tylergehring/Lux2ISO/docs/phase2/SchematicPhase2.jpg

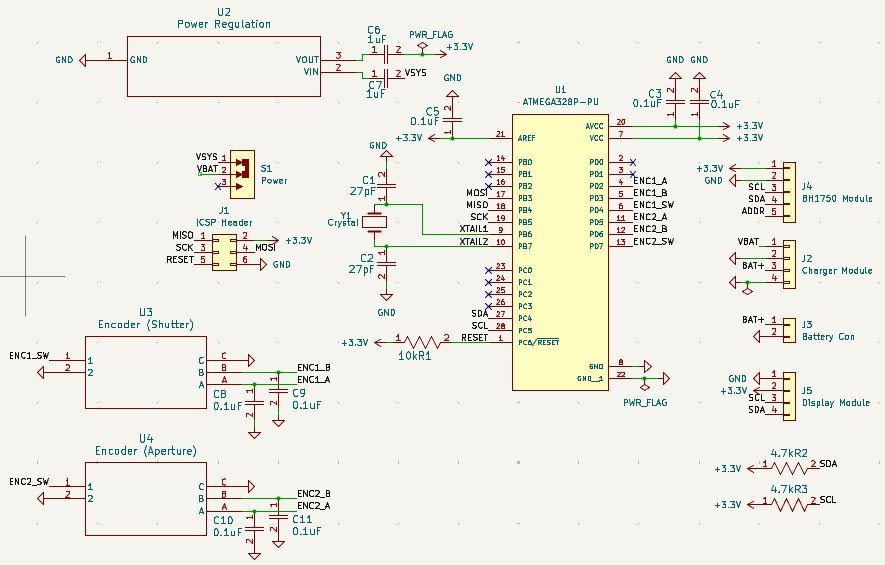
docs/phase2/SchematicPhase2.jpg
