tylergehring/Lux2ISO/docs/phase3/phase3_intended_final_schematic.png

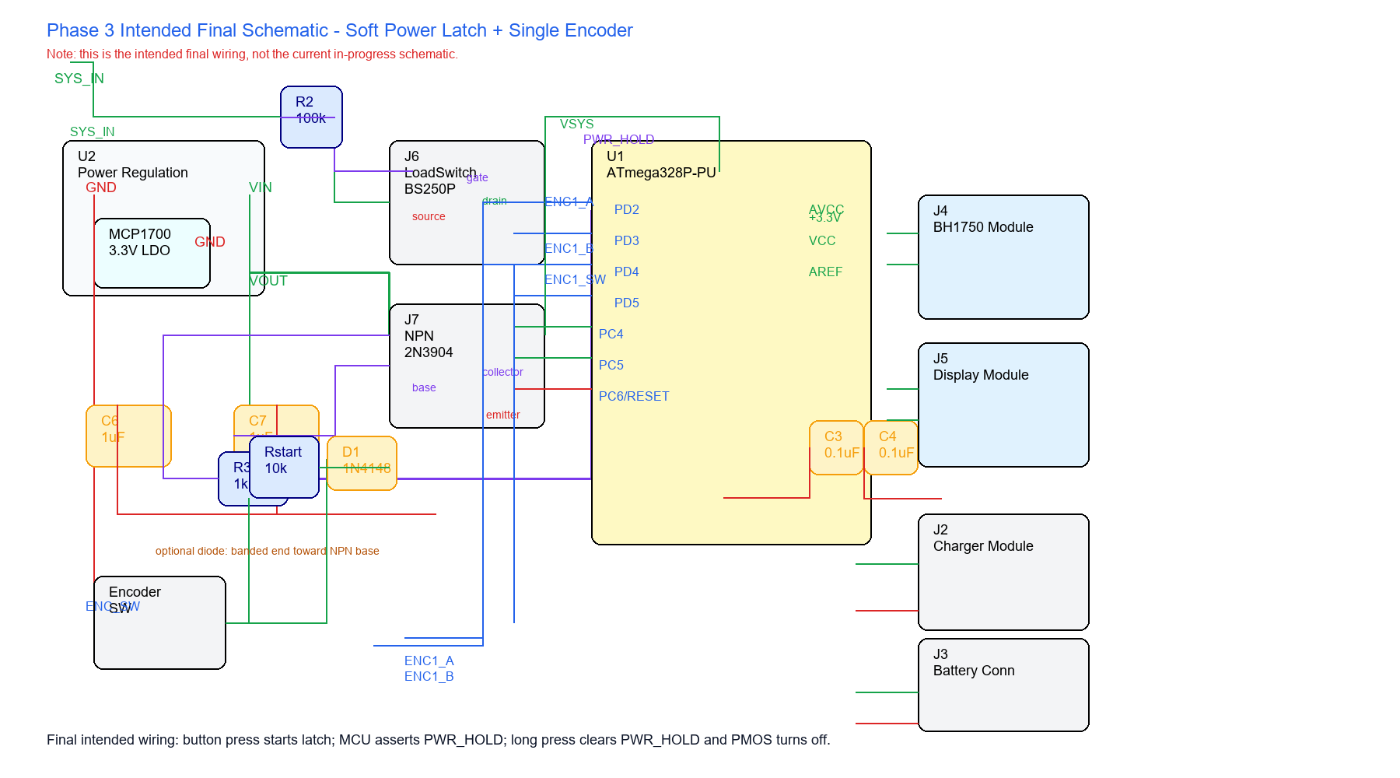
docs/phase3/phase3_intended_final_schematic.png
