tylergehring/Lux2ISO/docs/phase2/Phase2-BOM.md

# Lux2ISO Phase 2 — Complete Bill of Materials

All parts required to build Phase 2 from scratch. Links are verified against live DigiKey and Amazon listings.
Prices are unit prices at qty 1 in USD; verify current pricing before ordering.

---

## DigiKey Order

> Primary order: all ICs, passives, connectors, encoders, and PCB parts.

### Microcontroller & Clock

| Qty | Part Number | Description | Unit Price | DigiKey Link |
|-----|---|---|---|---|
| 1 | ATMEGA328P-PU | ATmega328P-PU, DIP-28, 8-bit MCU | $2.89 | [Link](https://www.digikey.com/en/products/detail/microchip-technology/ATMEGA328P-PU/1914589) |
| 1 | ED28DT | DIP-28 IC socket, 0.3" row spacing | $0.35 | [Link](https://www.digikey.com/en/products/detail/on-shore-technology-inc/ED28DT/4147600) |
| 1 | HC-49-U-S8000000ABJB | 8.000 MHz HC-49/U-S crystal | ~$0.50 | [Link](https://www.digikey.com/en/products/detail/citizen-finedevice-co-ltd/HC-49-U-S8000000ABJB/284205) |
| 2 | K270J15C0GF5TL2 | 27 pF C0G ceramic disc cap (crystal load caps) | ~$0.40 ea | [Link](https://www.digikey.com/en/products/detail/vishay-beyschlag-draloric-bc-components/K270J15C0GF5TL2/286460) |

### 3.3 V Power Regulation

| Qty | Part Number | Description | Unit Price | DigiKey Link |
|-----|---|---|---|---|
| 1 | MCP1700-3302E/TO | 3.3 V LDO, 250 mA, TO-92 **— use inline PCB footprint** | ~$0.50 | [Link](https://www.digikey.com/en/products/detail/microchip-technology/MCP1700-3302E-TO/652680) |
| 2 | *(any 1 µF radial electrolytic, 10 V+)* | 1 µF radial electrolytic (VIN + VOUT bypass, C8/C9) — search DigiKey for any in-stock Nichicon or Panasonic 1 µF 10 V or 16 V radial | ~$0.15 ea | [DigiKey search](https://www.digikey.com/en/products/filter/aluminum-electrolytic-capacitors/58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) |

> **MCP1700 soldering note:** Use the **TO-92 inline footprint** on the PCB (`Package_TO_SOT_THT:TO-92_Inline` in KiCad). Place the three holes in a straight line at **2.54 mm (0.1") pitch** instead of the standard cramped triangle. Bend the two outer leads of the TO-92 outward to match before inserting. This gives standard 0.1" clearance between adjacent pads, eliminating solder bridging. Do **not** use the standard triangle footprint.  
> **Note:** MCP1700 VIN will never exceed ~4.2 V (fully charged Li-Po). Any 1 µF radial aluminum electrolytic rated **≥10 V** works here. Search DigiKey for "1uF 10V radial electrolytic" and pick any in-stock Nichicon or Panasonic unit.

> **Note:** for the 1uF radical electrolytic I found this one "https://www.digikey.com/en/products/detail/w%C3%BCrth-elektronik/860020672005/5727088"

### USB-C Li-Po Charging

> All Li-Po charger ICs (MCP73831, TP4056, LTC4054, etc.) are SMD-only — no through-hole DIP version exists for any of them. The solution is to use a **TP4056 USB-C module** (see Amazon order below). The module mounts on the PCB via 2.54 mm through-hole pins and contains the charger IC, protection circuit, USB-C connector, and charge/fault indicator LEDs all on its own small PCB. No discrete SMD parts are required.

**TP4056 module pin connections to main PCB:**

| Module Pin | Connect to |
|---|---|
| OUT+ | Power switch input (VSYS+) |
| OUT− | GND |
| B+ | Li-Po battery positive |
| B− | Li-Po battery negative / GND |

> The module's built-in USB-C port accepts the charger cable directly — no separate USB-C connector is needed on the main PCB.

### Rotary Encoders

| Qty | Part Number | Description | Unit Price | DigiKey Link |
|-----|---|---|---|---|
| 2 | PEC11R-4215F-S0024 | Bourns 24-detent incremental encoder, integrated push switch, 15 mm shaft | $2.27 ea | [Link](https://www.digikey.com/en/products/detail/bourns-inc/PEC11R-4215F-S0024/4499665) |
| 4 | K104K15X7RF5TL2 | 100 nF X7R ceramic cap (encoder contact debounce, one per encoder phase A/B) | ~$0.25 ea | [Link](https://www.digikey.com/en/products/detail/vishay-beyschlag-draloric-bc-components/K104K15X7RF5TL2/286538) |

> **GPIO assignments:**
> - Encoder 1 (Shutter Speed): A = PD2, B = PD3, SW = PD4
> - Encoder 2 (Aperture): A = PD5, B = PD6, SW = PD7

### I2C Pull-ups & MCU Decoupling

| Qty | Part Number | Description | Unit Price | DigiKey Link |
|-----|---|---|---|---|
| 2 | CF14JT4K70 | 4.7 kΩ 1/4 W resistor (I2C SDA/SCL pull-ups) | $0.10 ea | [Link](https://www.digikey.com/en/products/detail/stackpole-electronics-inc/CF14JT4K70/1741428) |
| 1 | CF14JT10K0 | 10 kΩ 1/4 W resistor (ATmega RESET pull-up) | $0.10 | [Link](https://www.digikey.com/en/products/detail/stackpole-electronics-inc/CF14JT10K0/1741265) |
| 3 | K104K15X7RF5TL2 | 100 nF X7R ceramic cap (MCU VCC, AVCC, and AREF bypass; reuse same part as encoder debounce) | ~$0.25 ea | [Link](https://www.digikey.com/en/products/detail/vishay-beyschlag-draloric-bc-components/K104K15X7RF5TL2/286538) |

### Connectors, Headers & Switch

| Qty | Part Number | Description | Unit Price | DigiKey Link |
|-----|---|---|---|---|
| 1 | TSW-103-07-G-D | 2×3 2.54 mm ICSP header (Arduino-as-ISP programming) | ~$1.50 | [Link](https://www.digikey.com/en/products/detail/samtec-inc/TSW-103-07-G-D/1101274) |
| 1 | PH1-40-UA | 40-pin 2.54 mm breakaway single-row header (cut to fit BH1750, OLED, encoder signal pins) | ~$0.65 | [Link](https://www.digikey.com/en/products/detail/adam-tech/PH1-40-UA/22118795) |
| 1 | EG1218 | SPDT slide switch (power switch) | ~$0.50 | [Link](https://www.digikey.com/en/products/detail/e-switch/EG1218/101726) |
| 1 | S2B-PH-K-S(LF)(SN) | JST PH 2.0 mm 2-pin right-angle through-hole connector (Li-Po battery, board side) | ~$0.35 | [Link](https://www.digikey.com/en/products/detail/jst-sales-america-inc/S2B-PH-K-S-LF-SN/926626) |

---

## Amazon Order

| Qty | Description | Source | Link | Est. Price |
|-----|---|---|---|---|
| 1 | BH1750FVI ambient light sensor module | Amazon | [HiLetgo BH1750FVI](https://www.amazon.com/HiLetgo-BH1750FVI-intensity-illumination-arduino/dp/B00M0F29OS) | ~$3–5 |
| 1 | SSD1306 0.96" OLED display, **black PCB**, 128×64, I2C | Amazon | Search "SSD1306 0.96 OLED black PCB I2C 128x64" | ~$4–6 |
| 1 | **TP4056 USB-C Li-Po charger module with protection circuit** | Amazon | Search "TP4056 USB-C lipo charger module with protection" | ~$1–2 |
| 1 | 3.7 V 500 mAh Li-Po battery, JST PH 2 mm connector | Amazon | Search "3.7V 500mAh lipo battery JST PH 2mm" | ~$7–10 |

> **TP4056 module:** This is the **primary charging solution** for the PCB build (not just breadboard). It is an all-in-one module — through-hole mountable, includes USB-C input, protection circuit, and red/blue indicator LEDs. Buy the version labelled **"with protection"** (has a DW01A protection IC onboard). Mount on PCB via 4 header pins; wire OUT+/OUT− to the power switch and battery. The module's B+/B− pads connect to the JST-PH connector (S2B-PH-K-S in DigiKey order) so the battery unplugs cleanly.  
> **Battery:** Most 3.7V 500mAh Li-Po cells on Amazon ship with a JST-PH 2.0mm plug already attached — confirm before ordering.  
> **OLED note:** Look specifically for the **black PCB** version — some SSD1306 breakouts have a blue PCB and slightly different pinout labels.

---

## Summary: DigiKey Cart Totals

| Category | Parts | Est. Subtotal |
|---|---|---|
| MCU & Clock | ATMEGA328P-PU, socket, crystal, 27 pF caps | ~$5.00 |
| Power Regulation | MCP1700, 1 µF caps × 2 | ~$1.50 |
| Rotary Encoders × 2 | PEC11R + 4 debounce caps | ~$6.00 |
| Passives & Decoupling | 0.1 µF × 7, 4.7 kΩ × 2, 10 kΩ | ~$2.50 |
| Connectors & Switch | ICSP header, pin header, slide switch, JST battery connector | ~$2.85 |
| **DigiKey Subtotal** | | **~$18.50** |
| Amazon | BH1750, OLED, TP4056 module, Li-Po battery | **~$16–22** |
| **Total (Phase 2)** | | **~$34–40** |

> Prices exclude shipping. DigiKey orders over $35 USD typically qualify for free standard shipping.

---

## GPIO Pin Reference

```
ATmega328P-PU Phase 2 Pin Assignments
──────────────────────────────────────
PC4 (SDA)  → I2C — BH1750 & SSD1306
PC5 (SCL)  → I2C — BH1750 & SSD1306
PD2 (INT0) → Encoder 1 Phase A
PD3 (INT1) → Encoder 1 Phase B
PD4        → Encoder 1 Switch
PD5        → Encoder 2 Phase A
PD6        → Encoder 2 Phase B
PD7        → Encoder 2 Switch
PC6 (RESET)→ 10 kΩ pull-up to VCC; ICSP pin
```

---

## Verified Part Notes

- **PEC11R-4215F-S0024**: Use DigiKey ID **/4499665**. An older incorrect listing at /4499656 maps to a different encoder variant — double-check the part number before checkout.
- **ED28DT**: On Shore Technology DIP-28 socket. DigiKey ID /4147600. Confirm "0.3 inch" row spacing (standard for ATmega328P-PU).
- **1 µF bypass caps (C8/C9):** No specific part locked in — MCP1700 VIN never exceeds ~4.2 V, so any 1 µF radial electrolytic rated ≥10 V is a valid choice. Pick whatever Nichicon or Panasonic 1 µF 10 V–16 V radial is in stock on DigiKey at time of order.
- **S2B-PH-K-S(LF)(SN)**: JST PH 2.0 mm right-angle through-hole connector. Mates with the JST-PH plug that ships on most Li-Po cells from Amazon. Confirm the battery's plug polarity (red = +) before connecting.
- **MCP1700-3302E/TO footprint**: Use `Package_TO_SOT_THT:TO-92_Inline` (KiCad) — 3 holes in a straight line at 2.54 mm pitch. Bend the outer two leads outward before inserting. Avoids solder bridging that occurs with the standard TO-92 triangle footprint.
