tylergehring/Lux2ISO/docs/phase2/PartsList.md

# Parts list for Lux2ISO

## R3: 
- https://www.digikey.com/en/products/detail/stackpole-electronics-inc/CF14JT10K0/1741265 

## R1, R2: CF14JT4K70
-  https://www.digikey.com/en/products/detail/stackpole-electronics-inc/CF14JT4K70/1741428

## Crystal Caps (27pf), K270J15C0GF5TL2:
- https://www.digikey.com/en/products/detail/vishay-beyschlag-draloric-bc-components/K270J15C0GF5TL2/286460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

## C1, C4: 
- https://www.digikey.com/en/products/detail/vishay-beyschlag-draloric-bc-components/K104K15X7RF5TL2/286538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 

## ATMEGA328P-PU: 
- https://www.digikey.com/en/products/detail/microchip-technology/ATMEGA328P-PU/1914589 

## Crystal (8Mhz) 300-6017-ND: 
 - https://www.digikey.com/en/products/detail/citizen-finedevice-co-ltd/HC-49-U-S8000000ABJB/284205

## Switch: 
 - https://www.digikey.com/en/products/detail/e-switch/EG1218/101726 (imported)

## Button: 
 - https://www.digikey.com/en/products/detail/te-connectivity-alcoswitch-switches/1825910-6/1632536 (imported)

## BH1750:
- https://www.amazon.com/HiLetgo-BH1750FVI-intensity-illumination-arduino/dp/B00M0F29OS/ref=sr_1_1_sspa?crid=	1OF9UXPZ9TH5B&dib=eyJ2IjoiMSJ9.hpnGeritAro7UeeF0IUYTQkcFmc4CtMVolQaofVNv1FXlOjHIndQqKDstt3BYTSt74vklMJbbLEUwNah7sgf8BwpaUzsR1a6FS0AINDUkpn5CzaWQH1Z52IPd4V	OxiuHVxIkwN0nOMRwP0H1TW4WG2UsXDUI2m3jcWKKnHhsjRvRIfj5C22_nPuxmzp913Fhs2t5pQ-0NYBq40shShOc5HMPGy4A8M2quLCXaqgY7hI.CIiKslRwXxJ_vOf2Mvu9ubaDCF3Y-	KQRlmTWrb4szLc&dib_tag=se&keywords=BH1750&qid=1775579412&sprefix=bh1750%2Caps%2C206&sr=8-1-spons&sp_csd=d2lkZ2V0TmFtZT1zcF9hdGY&psc=1

## Display:
 - https://www.amazon.com/Teyleten-Robot-Display-SSD1306-Raspberry/dp/B0CN373JF4/ref=sr_1_1_sspa?	crid=F8D3HG513ZVB&dib=eyJ2IjoiMSJ9.IJoxWF1pbbgjuFzVxunath40VXw8RXnG4ks7BtYFZONdHKRY42OjVwCbkCfFFR3hJk9qmGtYoQ1UPL40owxuGn79IeBLamRzH8nQfgJumVX0LEXDtu9RDtk	urREBTC8-wqVHq8aHzR1b7RqAbRxUVt_SsmAz99e_--dy7fFW4m7fi_VnOSsqwhzQnPsLZro0K_upS-XZJNJXFKxSzpEqFD9LsWfPxPeca_vx35r6nuk.lQK0ORfxNT16He6ogQIBO_	0ilh6oPLe_aTcS_LoIm78&dib_tag=se&keywords=128x64+oled+display&qid=1775579473&sprefix=128x64+oled+display%2Caps%2C174&sr=8-1-	spons&sp_csd=d2lkZ2V0TmFtZT1zcF9hdGY&psc=1

## Programmable:
- https://www.digikey.com/en/products/detail/samtec-inc/TSW-103-07-G-D/1101274

## J1 (To Sensor), (basic 4 pin connector):
- https://www.digikey.com/en/products/detail/adam-tech/PH1-40-UA/22118795

## Display1 (connector):
- Use the 4 pin connector above and buy female to female cables

## Battery (connector): 
- 2 pin wire to battery

## linear voltage regulator: MCP1700-3302:
- https://www.digikey.com/en/products/detail/microchip-technology/MCP1700-3302E-TO/652680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

## 1nf Cap: C315C102J5G5TA: 
- https://www.digikey.com/en/products/detail/kemet/C315C102J5G5TA/12700309
