tylergehring/Lux2ISO/(commit log)

2026-03-10 test: read-sensor
2026-03-24 feat: working-light-sensor-and-display
2026-05-16 fix: through-hole-parts
2026-06-19 fix: bom
